javanaut-de/camino/inventor/ls-halterung/ls_halterung.stl

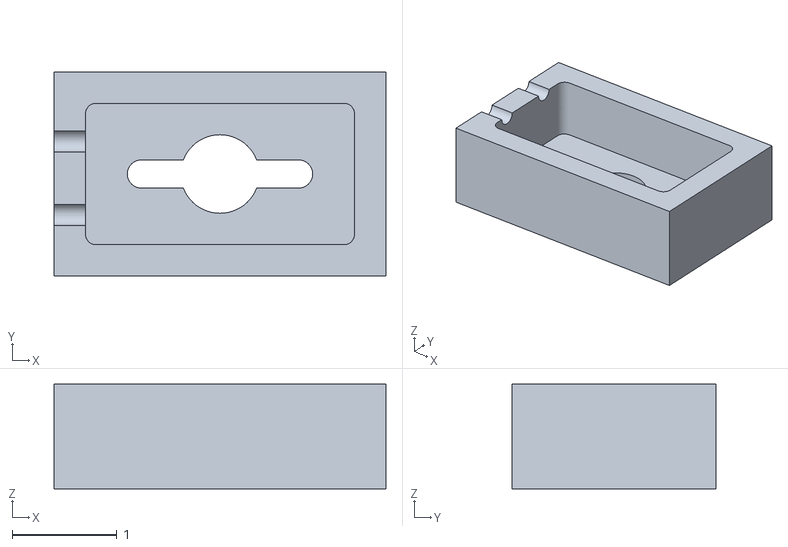
[picture p1: CAD file, 2020-07-20]
inventor/ls-halterung/ls_halterung.stl
3.17 x 1.95 x 1.00
