javanaut-de/camino/inventor/lcd-halterung/oled_halterung_W162_links.stl

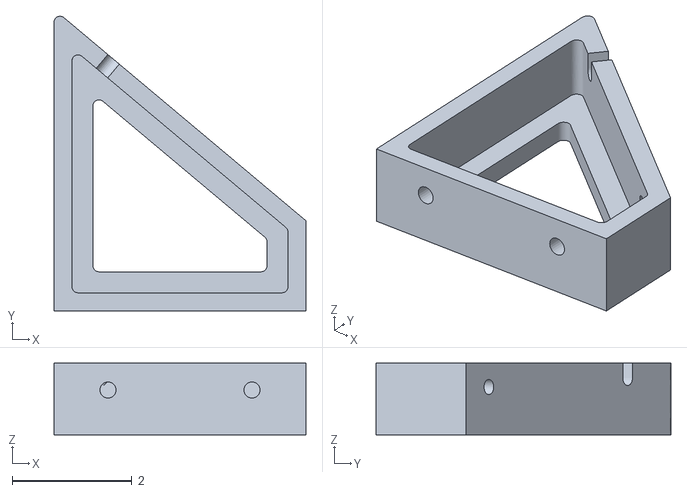
[picture p2: CAD file, 2020-07-20]
inventor/lcd-halterung/oled_halterung_W162_links.stl
4.20 x 4.91 x 1.20
