javanaut-de/camino/inventor/lcd-halterung/lcd_halterung_162C_rechts.stl

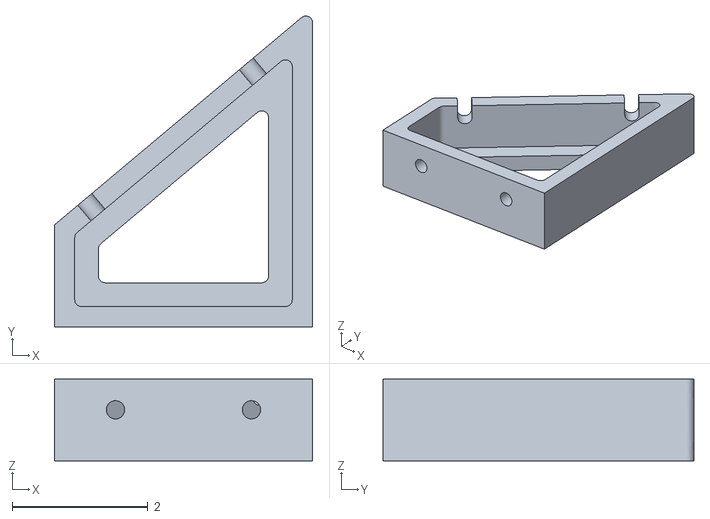
[picture p3: CAD file, 2020-07-20]
inventor/lcd-halterung/lcd_halterung_162C_rechts.stl
3.80 x 4.57 x 1.20
