javanaut-de/camino/(list of files, cad)

Other CAD files:
inventor/lcd-halterung/oled_halterung_W162.dwg
inventor/lcd-halterung/oled_halterung_W162_rechts.stl
inventor/lcd-halterung/lcd_halterung_162C.dwg
inventor/lcd-halterung/lcd_halterung_162C_links.stl
inventor/lcd-halterung/lcd_halterung_162C_links.ipt
inventor/lcd-halterung/lcd_halterung_162C_rechts.ipt
inventor/lcd-halterung/oled_halterung_W162_links.ipt
inventor/lcd-halterung/oled_halterung_W162_rechts.ipt
inventor/ls-halterung/ls-halterung.ipt
