javanaut-de/camino/inventor/lcd-halterung/lcd_halterung_162C.pdf

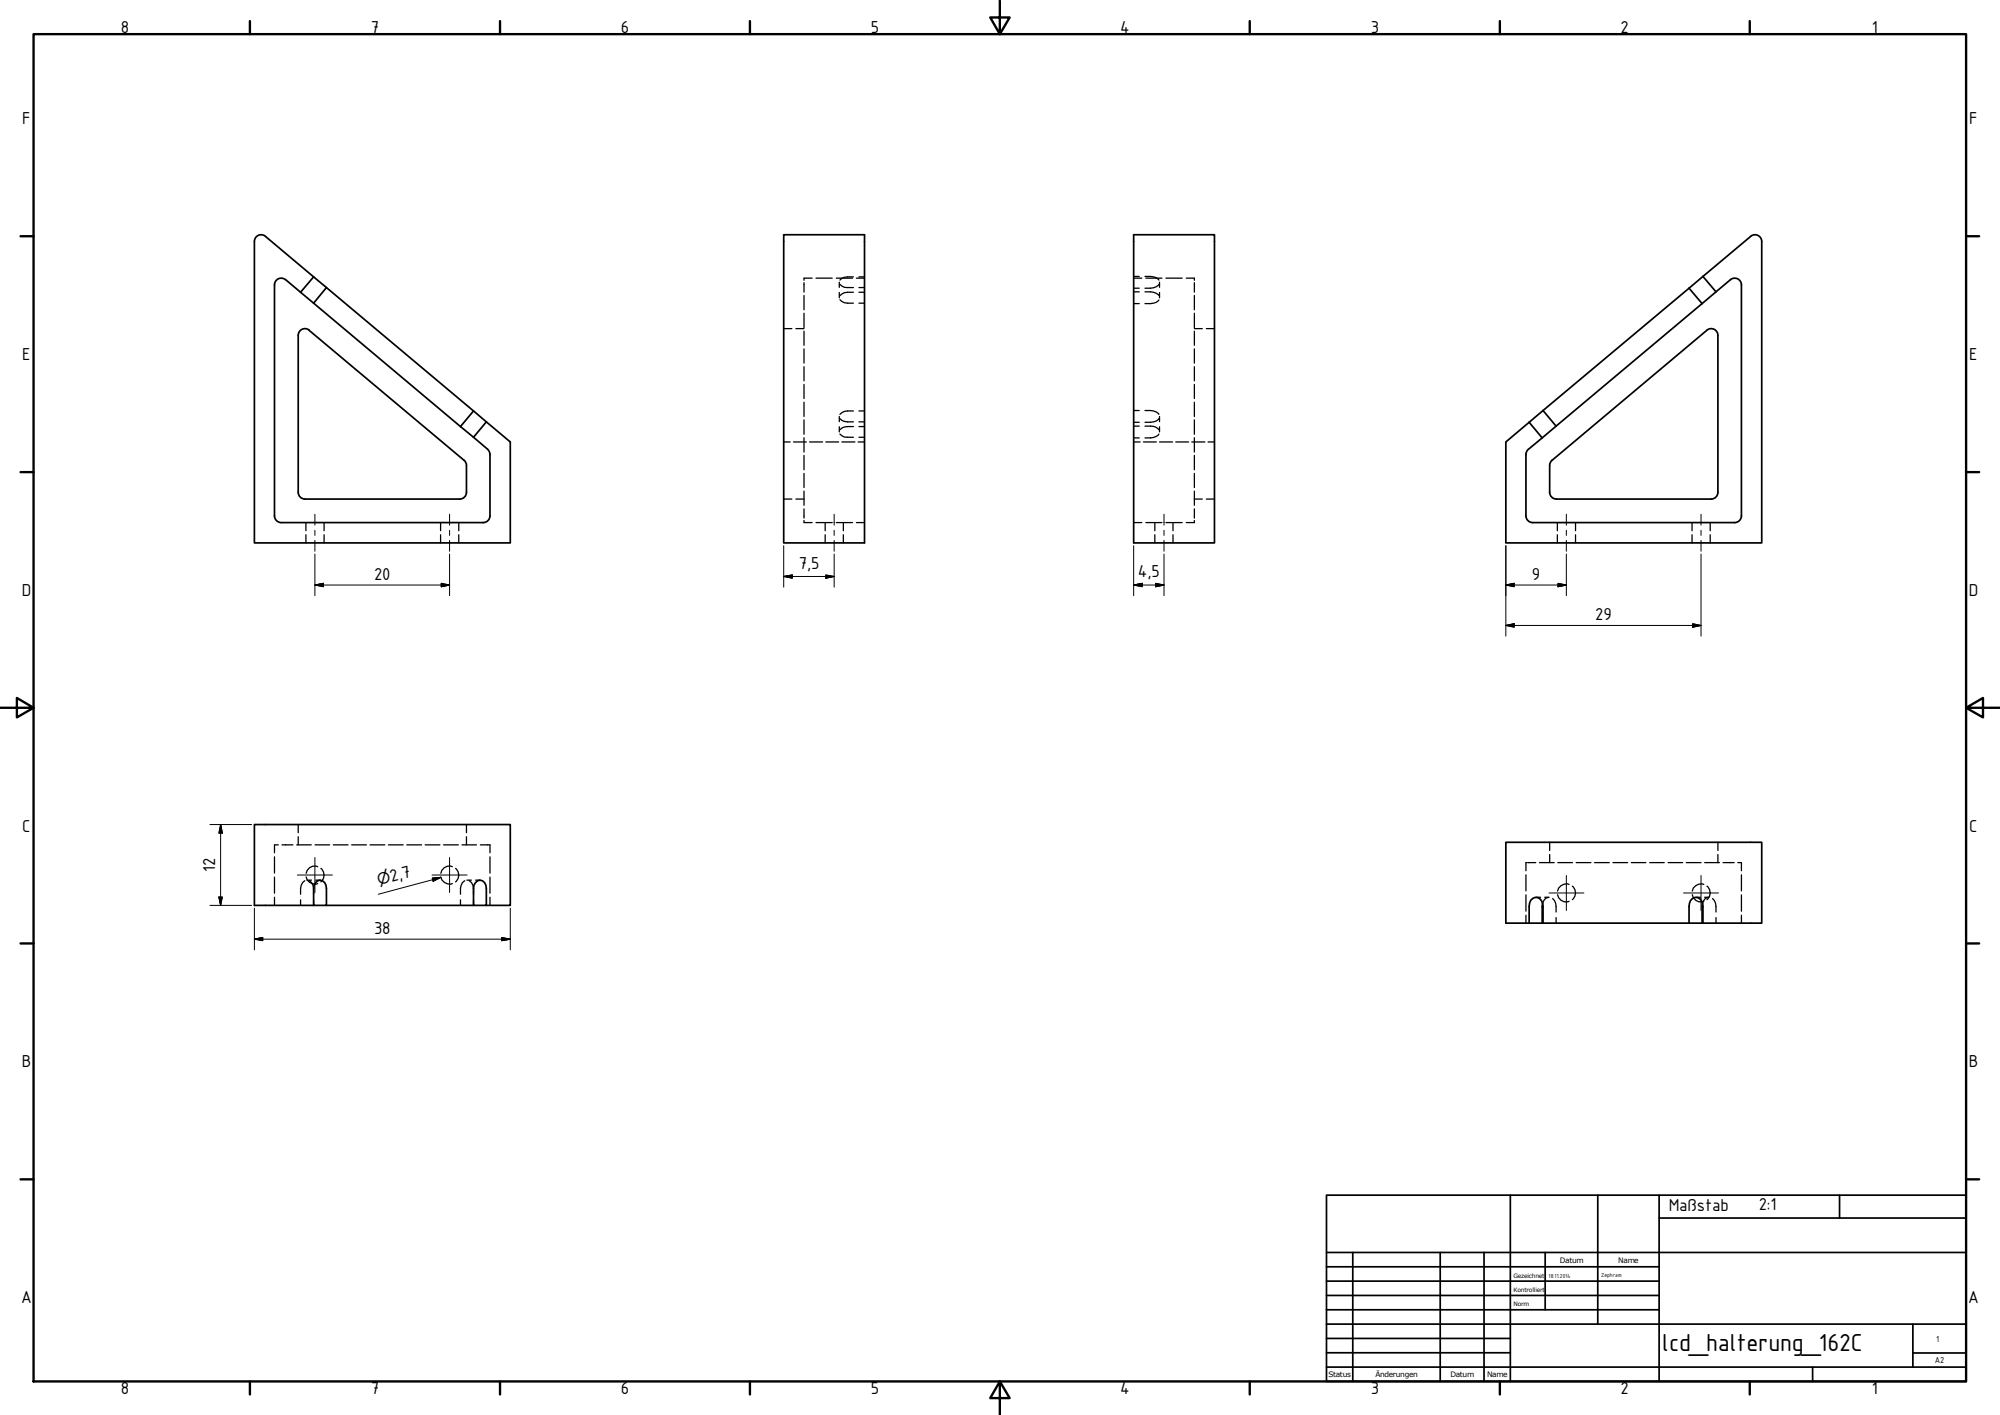
[picture p4: page 1]
lcd_halterung_162C; Status; bnderungen; Datum; Name; Gezeichnet; Kontrolliert; Norm; Zephram; Mastab
