javanaut-de/camino/inventor/lcd-halterung/oled_halterung_W162.pdf

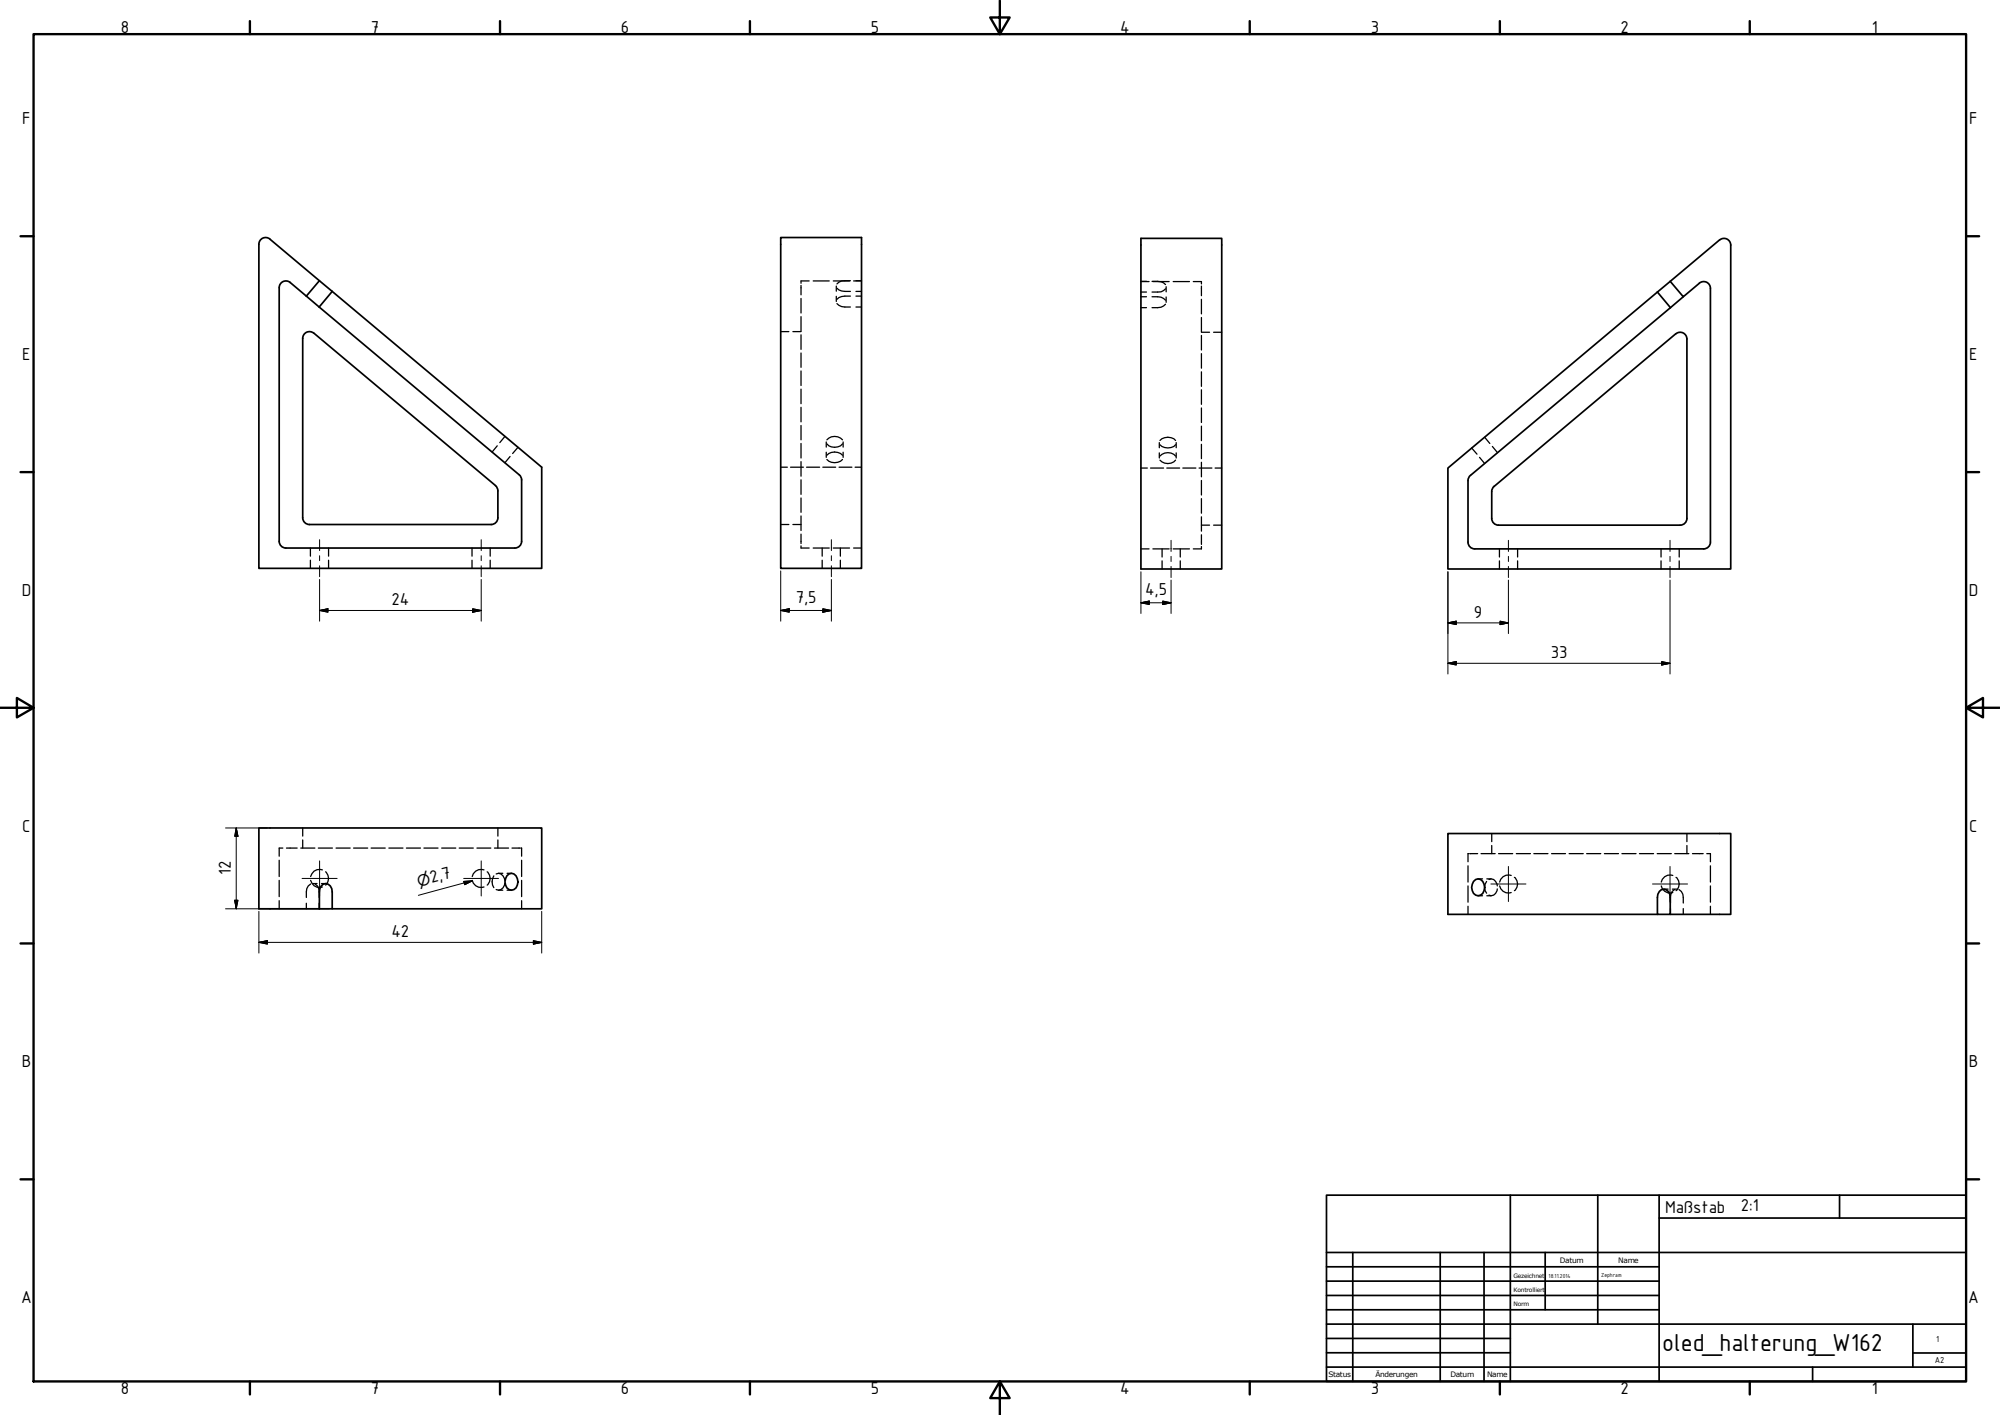
[picture p5: page 1]
oled_halterung_W162; Status; bnderungen; Datum; Name; Gezeichnet; Kontrolliert; Norm; Zephram; Mastab 2:1
