javanaut-de/camino/kicad/camino.kicad_pcb

## KiCad design kicad/camino.kicad_pcb (2020-07-20)

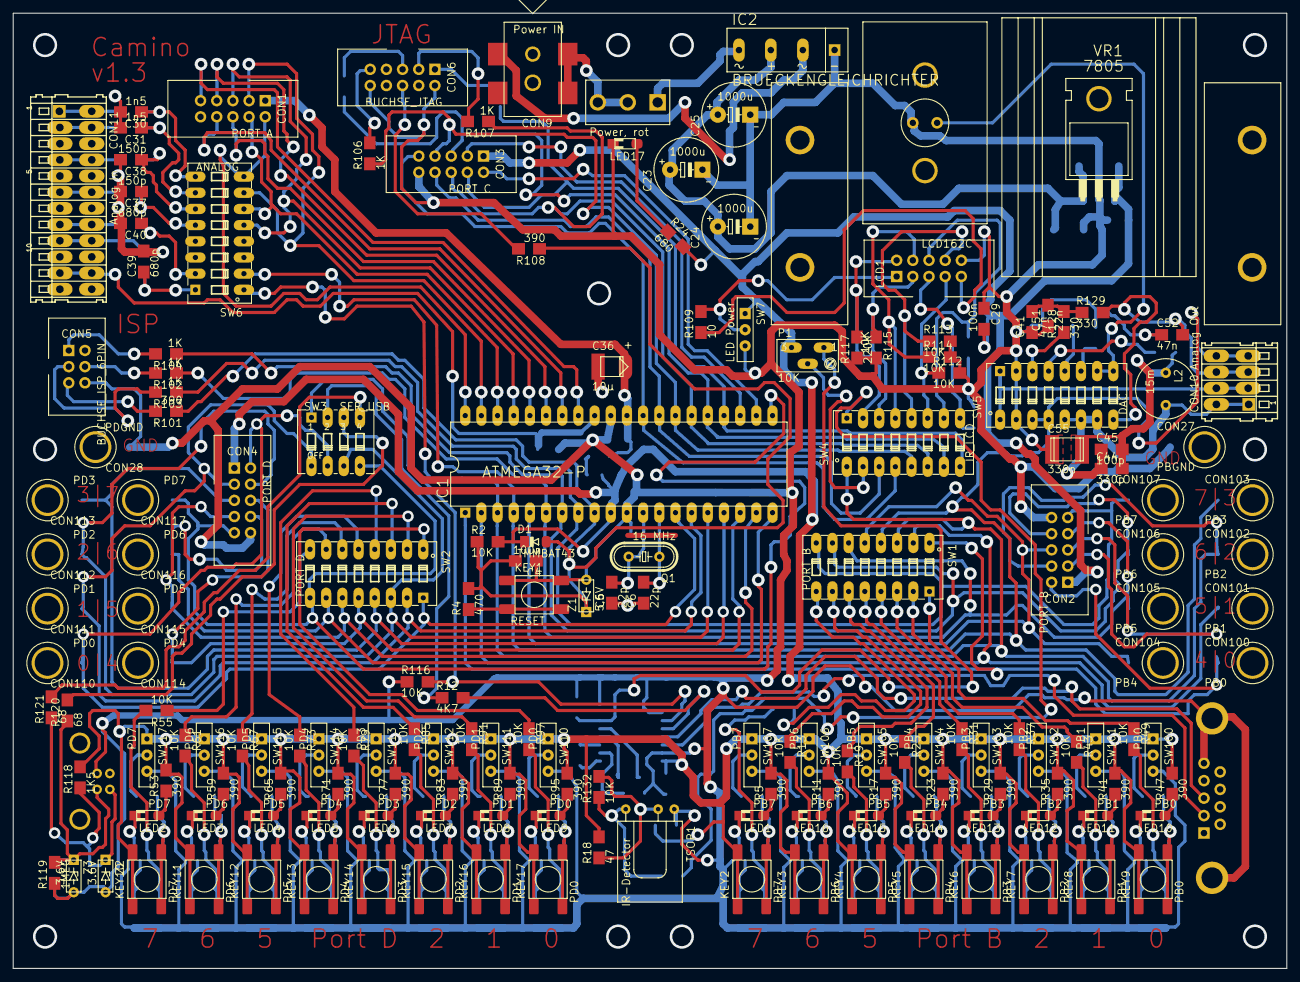
[picture p6: board camino.kicad_pcb from above]

Board: 2 copper layers, 200.0 x 150.0 mm, 306 parts (0 on the bottom side), 216 nets.

Parts:
C1, C2, C3, C4, C26, C28, C29, C32, C33, C34, C35, C47: 100n; KONDENSATOR_SMD_1206
C5, C6: 22p; KONDENSATOR_SMD_1206
C7, C8, C9, C10, C11, C12, C13, C14, C15, C16, C17, C18, C19, C20, C21, C22: 220n; KONDENSATOR_SMD_1206
C23, C24, C25: 1000u; ELKO_RADIAL_11MM
C27, C46, C55: 330n; KONDENSATOR_SMD_1812
C30, C31: 1n5; KONDENSATOR_SMD_1206
C36: 10µ; ELKO_SMD_TM_B
C37, C38: 150p; KONDENSATOR_SMD_1206
C39, C40: 680p; KONDENSATOR_SMD_1206
C41, C52: 47n; KONDENSATOR_SMD_1206
C42, C51: 22n; KONDENSATOR_SMD_1206
C44: 330p; KONDENSATOR_SMD_1206
C45, C49, C50: 100p; KONDENSATOR_SMD_1206
CON1: PORT A; PFOSTENSTIFTLEISTE_10PIN
CON2: PORT B; PFOSTENSTIFTLEISTE_10PIN
CON3: PORT C; PFOSTENSTIFTLEISTE_10PIN
CON4: PORT D; PFOSTENSTIFTLEISTE_10PIN
CON5: BUCHSE_ISP_6PIN; PFOSTENSTIFTLEISTE_6PIN
CON6: BUCHSE_JTAG; PFOSTENSTIFTLEISTE_10PIN
CON7: RS232; BUCHSE_SERIELL_SUBD9_PIN
CON8: BUCHSE_USB_B; BUCHSE_USB_B_PIN
CON9: Power IN; BUCHSE_DC
CON10: Analog Out; KLEMMBUCHSE_WAGO_233_504_4PIN
CON11: Analog In; KLEMMBUCHSE_WAGO_233_512_12PIN
CON27: PBGND; BUCHSE_LABOR_2MM
CON28: PDGND; BUCHSE_LABOR_2MM
CON100: PB0; BUCHSE_LABOR_2MM
CON101: PB1; BUCHSE_LABOR_2MM
CON102: PB2; BUCHSE_LABOR_2MM
CON103: PB3; BUCHSE_LABOR_2MM
CON104: PB4; BUCHSE_LABOR_2MM
CON105: PB5; BUCHSE_LABOR_2MM
CON106: PB6; BUCHSE_LABOR_2MM
CON107: PB7; BUCHSE_LABOR_2MM
CON110: PD0; BUCHSE_LABOR_2MM
CON111: PD1; BUCHSE_LABOR_2MM
CON112: PD2; BUCHSE_LABOR_2MM
CON113: PD3; BUCHSE_LABOR_2MM
CON114: PD4; BUCHSE_LABOR_2MM
CON115: PD5; BUCHSE_LABOR_2MM
CON116: PD6; BUCHSE_LABOR_2MM
CON117: PD7; BUCHSE_LABOR_2MM
D1: TMMBAT43; DIODE_MINIMELF
D2: S4D; DIODE_SMD_DO214AB
IC1: ATMEGA32-P; DIL40
IC2: BRUECKENGLEICHRICHTER; GLEICHRICHTER_SIL4
IC3: MAX202SO16L; SO16L
KEY1: RESET; TASTER_LSG1301
KEY2: PB7; TASTER_LSG1301
KEY3: PB6; TASTER_LSG1301
KEY4: PB5; TASTER_LSG1301
KEY5: PB4; TASTER_LSG1301
KEY6: PB3; TASTER_LSG1301
KEY7: PB2; TASTER_LSG1301
KEY8: PB1; TASTER_LSG1301
KEY9: PB0; TASTER_LSG1301
KEY10: PD7; TASTER_LSG1301
KEY11: PD6; TASTER_LSG1301
KEY12: PD5; TASTER_LSG1301
KEY13: PD4; TASTER_LSG1301
KEY14: PD3; TASTER_LSG1301
KEY15: PD2; TASTER_LSG1301
KEY16: PD1; TASTER_LSG1301
KEY17: PD0; TASTER_LSG1301
L1: 10u; SPULE_SMD_1008
L2: 15m; SPULE_RADIAL_200MIL
LCD1: LCD162C; LCD_PULT_162C_BC
LED1: PB7; LED_KINGBRIGHT
LED2: PD7; LED_KINGBRIGHT
LED3: PD6; LED_KINGBRIGHT
LED4: PD5; LED_KINGBRIGHT
LED5: PD4; LED_KINGBRIGHT
LED6: PD3; LED_KINGBRIGHT
LED7: PD2; LED_KINGBRIGHT
LED8: PD1; LED_KINGBRIGHT
LED9: PD0; LED_KINGBRIGHT
LED10: PB0; LED_KINGBRIGHT
LED11: PB1; LED_KINGBRIGHT
LED12: PB2; LED_KINGBRIGHT
LED13: PB3; LED_KINGBRIGHT
LED14: PB4; LED_KINGBRIGHT
LED15: PB5; LED_KINGBRIGHT
LED16: PB6; LED_KINGBRIGHT
LED17: Power, rot; LED_KINGBRIGHT
P1: 10K; 3296Y
Q1: 16 MHz; HC49U
R1: 4R7; WIDERSTAND_SMD_1206
R2, R7, R10, R13, R16, R19, R22, R25, R28, R31, R34, R37, R40, R43, R46, R49, R52, R55, R58, R61, R64, R67, R70, R73, R76, R79, R82, R85, R88, R91, R94, R97, R100, R110, R111, R112, R113, R114, R115, R116, R122, R123, R124, R125, R132: 10K; WIDERSTAND_SMD_1206
R3, R6, R102, R103, R104, R105, R106, R107: 1K; WIDERSTAND_SMD_1206
R4: 470; WIDERSTAND_SMD_1206
R5, R11, R17, R23, R29, R35, R41, R47, R53, R59, R65, R71, R77, R83, R89, R95, R101, R108: 390; WIDERSTAND_SMD_1206
R8, R14, R20, R26, R30, R32, R36, R38, R42, R44, R48, R50, R54, R56, R60, R62, R66, R68, R72, R74, R78, R80, R84, R86, R90, R92, R96, R98, R133, R134, R135, R136: 470K; WIDERSTAND_SMD_1206
R9, R15, R21, R27, R33, R39, R45, R51, R57, R63, R69, R75, R81, R87, R93, R99, R126, R127: 100K; WIDERSTAND_SMD_1206
R12: 4K7; WIDERSTAND_SMD_1206
R18: 47; WIDERSTAND_SMD_1206
R24: 680; WIDERSTAND_SMD_1206
R109: 10; WIDERSTAND_SMD_1206
R117: 220K; WIDERSTAND_SMD_1206
R118: 1K5; WIDERSTAND_SMD_1206
R119: 1MEG; WIDERSTAND_SMD_1206
R120, R121: 68; WIDERSTAND_SMD_1206
R128, R129, R130, R131: 330; WIDERSTAND_SMD_1206
SPK1: LAUTSPRECHER; LAUTSPRECHER_BOX
SW1: PORT B; SCHALTER_DIP8
SW2: PORT D; SCHALTER_DIP8
SW3: SER_USB; SCHALTER_DIP4
SW4: IR_LCD; SCHALTER_DIP8
SW5: DAC; SCHALTER_DIP8
SW6: ANALOG; SCHALTER_DIP8
SW7: LED Power; SCHALTER_1UM_ESP
SW23: MAIN; SCHALTER_KNITTER
SW100: PB0; SCHALTER_1UM_ESP
SW101: PB1; SCHALTER_1UM_ESP
SW102: PB2; SCHALTER_1UM_ESP
SW103: PB3; SCHALTER_1UM_ESP
SW104: PB4; SCHALTER_1UM_ESP
SW105: PB5; SCHALTER_1UM_ESP
SW106: PB6; SCHALTER_1UM_ESP
SW107: PB7; SCHALTER_1UM_ESP
SW110: PD0; SCHALTER_1UM_ESP
SW111: PD1; SCHALTER_1UM_ESP
SW112: PD2; SCHALTER_1UM_ESP
SW113: PD3; SCHALTER_1UM_ESP
SW114: PD4; SCHALTER_1UM_ESP
SW115: PD5; SCHALTER_1UM_ESP
SW116: PD6; SCHALTER_1UM_ESP
SW117: PD7; SCHALTER_1UM_ESP
T1, T2, T3, T4, T5, T6, T7, T8, T9, T10, T11, T12, T13, T14, T15, T16: IRLML2502; SOT-23
TSOP1: IR-Detector; RECEIVER_TSOP_LIEGEND
VR1: 7805; TO220_LIEGEND_KUEHLKOERPER_STRANG
Z1: 5,6V; ZENER_PIN_200MIL
Z2, Z3: 3.6V; ZENER_PIN_200MIL

Connections:
/RESET: C4.2, D1.A, IC1.9, R2.1, R4.2, R101.1, R108.1, Z1.K
AVCC: C3.2, C36.POS, CON1.P$1, IC1.30, R1.1
GND: C1.1, C2.2, C3.1, C4.1, C5.1, C6.1, C7.1, C8.1, C9.1, C10.1, C11.1, C12.1, C13.1, C14.1, C15.1, C16.1, C17.1, C18.1, C19.1, C20.1, C21.1, C22.1, C23.-, C24.-, C25.-, C26.1, C27.1, C28.1, C29.1, C30.2, C31.2, C34.2, C35.2, C36.NEG, C37.2, C38.2, C39.2, C40.2, C41.1, C42.1, C46.1, C47.1, C49.1, C50.1, C51.1, C52.1, C55.2, CON1.P$10, CON2.P$10, CON3.P$10, CON4.P$10, CON5.P$6, CON6.P$2, CON6.P$10, CON7.5, CON7.G1, CON7.G2, CON8.GND, CON10.A2, CON10.B2, CON11.A3, CON11.A5, CON11.A7, CON11.A10, CON11.A12, CON11.B3, CON11.B5, CON11.B7, CON11.B10, CON11.B12, CON27.PAD, CON28.PAD, IC1.11, IC1.31, IC2.NEG, IC3.8, IC3.10, KEY1.P$1, KEY1.P$2, LCD1.GND, LED17.K, R8.1, R14.1, R20.1, R26.1, R32.1, R38.1, R44.1, R50.1, R56.1, R62.1, R68.1, R74.1, R80.1, R86.1, R92.1, R98.1, R110.2, R111.2, R112.2, R113.2, R114.2, R115.2, R116.1, R117.1, R119.1, R131.1, SPK1.1, SW5.1, SW5.2, SW5.15, SW5.16, SW6.3, SW6.4, SW6.13, SW6.14, SW7.OFF, SW100.OFF, SW101.OFF, SW102.OFF, SW103.OFF, SW104.OFF, SW105.OFF, SW106.OFF, SW107.OFF, SW110.OFF, SW111.OFF, SW112.OFF, SW113.OFF, SW114.OFF, SW115.OFF, SW116.OFF, SW117.OFF, T1.P$2, T2.P$2, T3.P$2, T4.P$2, T5.P$2, T6.P$2, T7.P$2, T8.P$2, T9.P$2, T10.P$2, T11.P$2, T12.P$2, T13.P$2, T14.P$2, T15.P$2, T16.P$2, TSOP1.GND, VR1.2, Z1.A, Z2.A, Z3.A
unnamed: C1.2, CON11.A11, CON11.B11, IC1.32
unnamed: C5.2, IC1.12, Q1.2
unnamed: C6.2, IC1.13, Q1.1
unnamed: C7.2, R7.2, R9.2, R36.2
unnamed: C8.2, R13.2, R15.2, R42.2
unnamed: C9.2, R19.2, R21.2, R48.2
unnamed: C10.2, R25.2, R27.2, R54.2
unnamed: C11.2, R31.2, R33.2, R60.2
unnamed: C12.2, R37.2, R39.2, R66.2
unnamed: C13.2, R43.2, R45.2, R72.2
unnamed: C14.2, R49.2, R51.2, R78.2
unnamed: C15.2, R55.2, R57.2, R136.2
unnamed: C16.2, R61.2, R63.2, R135.2
unnamed: C17.2, R67.2, R69.2, R134.2
unnamed: C18.2, R73.2, R75.2, R133.2
unnamed: C19.2, R30.1, R79.2, R81.2
unnamed: C20.2, R85.2, R87.2, R96.2
unnamed: C21.2, R90.2, R91.2, R93.2
unnamed: C22.2, R84.2, R97.2, R99.2
unnamed: C23.+, C24.+, C25.+, C27.2, D2.K, IC2.POS, VR1.1
unnamed: C30.1, R127.1, SW6.9
unnamed: C31.1, R126.1, SW6.10
unnamed: C32.1, IC3.1
unnamed: C32.2, IC3.3
unnamed: C33.1, IC3.4
unnamed: C33.2, IC3.5
unnamed: C34.1, IC3.2
unnamed: C35.1, IC3.6, P1.A
unnamed: C37.1, R124.1, SW6.12
unnamed: C38.1, R125.1, SW6.11
unnamed: C39.1, R122.1, SW6.16
unnamed: C40.1, R123.1, SW6.15
unnamed: C41.2, C51.2, R128.2, R129.1
unnamed: C42.2, C52.2, CON10.A3, CON10.B3, R129.2, SW5.8
unnamed: C44.1, C45.1, CON10.A1, CON10.B1, L2.P$2, SW5.5, SW5.6, SW5.7
unnamed: C44.2, C45.2, C55.1, L2.P$1, R130.2
unnamed: C46.2, SW5.12
unnamed: C49.2, CON8.D-, R118.1, R121.1, Z2.K
unnamed: C50.2, CON8.D+, R119.2, R120.1, Z3.K
unnamed: CON1.P$2, IC1.40, SW6.8
unnamed: CON1.P$3, IC1.39, SW6.7
unnamed: CON1.P$4, IC1.38, SW6.6
unnamed: CON1.P$5, IC1.37, SW6.5
unnamed: CON1.P$6, IC1.36
unnamed: CON1.P$7, IC1.35
unnamed: CON1.P$8, IC1.34
unnamed: CON1.P$9, IC1.33
unnamed: CON3.P$2, IC1.22
unnamed: CON3.P$3, IC1.23
unnamed: CON3.P$4, IC1.24, R105.1, SW4.8
unnamed: CON3.P$5, IC1.25, R3.1, SW4.7
unnamed: CON3.P$6, IC1.26, R107.1, SW4.6
unnamed: CON3.P$7, IC1.27, R106.1, SW4.5
unnamed: CON3.P$8, IC1.28, SW4.3
unnamed: CON3.P$9, IC1.29, SW4.4
unnamed: CON5.P$1, R104.2
unnamed: CON5.P$3, R103.2
unnamed: CON5.P$4, R102.2
unnamed: CON5.P$5, R101.2
unnamed: CON6.P$1, R105.2
unnamed: CON6.P$3, R107.2
unnamed: CON6.P$5, R3.2
unnamed: CON6.P$6, R108.2
unnamed: CON6.P$9, R106.2
unnamed: CON7.2, IC3.14
unnamed: CON7.3, IC3.13
unnamed: CON9.FEDER, IC2.AC2
unnamed: CON9.STIFT_A, CON9.STIFT_B, SW23.OFF, SW23.SW
unnamed: CON2.P$5, CON10.A4, CON10.B4, CON103.PAD, IC1.4, SW1.4, SW5.3, SW5.4, SW6.2
unnamed: CON11.A1, CON11.B1, R127.2
unnamed: CON11.A2, CON11.B2, R126.2
unnamed: CON11.A4, CON11.B4, R125.2
unnamed: CON11.A6, CON11.B6, R124.2
unnamed: CON11.A8, CON11.B8, R123.2
unnamed: CON11.A9, CON11.B9, R122.2
unnamed: CON2.P$2, CON100.PAD, IC1.1, SW1.1
unnamed: CON2.P$3, CON101.PAD, IC1.2, SW1.2
unnamed: CON2.P$4, CON102.PAD, IC1.3, SW1.3, SW4.1, SW6.1
unnamed: CON2.P$6, CON104.PAD, IC1.5, SW1.5
unnamed: CON2.P$7, CON105.PAD, IC1.6, R102.1, SW1.6
unnamed: CON2.P$8, CON106.PAD, IC1.7, R104.1, SW1.7
unnamed: CON2.P$9, CON107.PAD, IC1.8, R103.1, SW1.8
unnamed: CON4.P$2, CON110.PAD, IC1.14, SW2.16, SW3.2
unnamed: CON4.P$3, CON111.PAD, IC1.15, SW2.15, SW3.1
unnamed: CON4.P$4, CON112.PAD, IC1.16, SW2.14, SW3.3
unnamed: CON4.P$5, CON113.PAD, IC1.17, SW2.13
unnamed: CON4.P$6, CON114.PAD, IC1.18, SW2.12
unnamed: CON4.P$7, CON115.PAD, IC1.19, SW2.11
unnamed: CON4.P$8, CON116.PAD, IC1.20, SW2.10
unnamed: CON4.P$9, CON117.PAD, IC1.21, SW2.9, SW3.4
unnamed: IC2.AC1, SW23.ON
unnamed: IC3.11, R116.2, SW3.8
unnamed: IC3.12, R12.2
unnamed: KEY1.P$3, KEY1.P$4, R4.1
unnamed: KEY2.P$3, KEY2.P$4, R9.1, R10.2
unnamed: KEY3.P$3, KEY3.P$4, R15.1, R16.2
unnamed: KEY4.P$3, KEY4.P$4, R21.1, R22.2
unnamed: KEY5.P$3, KEY5.P$4, R27.1, R28.2
unnamed: KEY6.P$3, KEY6.P$4, R33.1, R34.2
unnamed: KEY7.P$3, KEY7.P$4, R39.1, R40.2
unnamed: KEY8.P$3, KEY8.P$4, R45.1, R46.2
unnamed: KEY9.P$3, KEY9.P$4, R51.1, R52.2
unnamed: KEY10.P$3, KEY10.P$4, R57.1, R58.2
unnamed: KEY11.P$3, KEY11.P$4, R63.1, R64.2
unnamed: KEY12.P$3, KEY12.P$4, R69.1, R70.2
unnamed: KEY13.P$3, KEY13.P$4, R75.1, R76.2
unnamed: KEY14.P$3, KEY14.P$4, R81.1, R82.2
unnamed: KEY15.P$3, KEY15.P$4, R87.1, R88.2
unnamed: KEY16.P$3, KEY16.P$4, R93.1, R94.2
unnamed: KEY17.P$3, KEY17.P$4, R99.1, R100.2
unnamed: L1.P$1, R1.2
unnamed: LCD1.DB0, R110.1, SW4.9
unnamed: LCD1.DB1, R111.1, SW4.10
unnamed: LCD1.DB2, R112.1, SW4.11
unnamed: LCD1.DB3, R113.1, SW4.12
unnamed: LCD1.E, R114.1, SW4.13
unnamed: LCD1.RS, R115.1, SW4.14
unnamed: LCD1.VCC, R109.2, SW7.SLIDER
unnamed: LCD1.VCON, R117.2, SW4.15
unnamed: LCD1.VLED, R109.1
unnamed: LED1.A, R5.1
unnamed: LED1.K, T1.P$3
unnamed: LED2.A, R53.1
unnamed: LED2.K, T9.P$3
unnamed: LED3.A, R59.1
unnamed: LED3.K, T10.P$3
unnamed: LED4.A, R65.1
unnamed: LED4.K, T11.P$3
unnamed: LED5.A, R71.1
unnamed: LED5.K, T12.P$3
unnamed: LED6.A, R77.1
unnamed: LED6.K, T13.P$3
unnamed: LED7.A, R83.1
unnamed: LED7.K, T14.P$3
unnamed: LED8.A, R89.1
unnamed: LED8.K, T15.P$3
unnamed: LED9.A, R95.1
unnamed: LED9.K, T16.P$3
unnamed: LED10.A, R47.1
unnamed: LED10.K, T8.P$3
unnamed: LED11.A, R41.1
unnamed: LED11.K, T7.P$3
unnamed: LED12.A, R35.1
unnamed: LED12.K, T6.P$3
unnamed: LED13.A, R29.1
unnamed: LED13.K, T5.P$3
unnamed: LED14.A, R23.1
unnamed: LED14.K, T4.P$3
unnamed: LED15.A, R17.1
unnamed: LED15.K, T3.P$3
unnamed: LED16.A, R11.1
unnamed: LED16.K, T2.P$3
unnamed: LED17.A, R24.1
unnamed: P1.S, SW4.2
unnamed: R6.2, SW4.16
unnamed: R7.1, SW1.9
unnamed: R10.1, SW107.SLIDER
unnamed: R12.1, SW3.7
unnamed: R13.1, SW1.10
unnamed: R14.2, R42.1, T2.P$1
unnamed: R16.1, SW106.SLIDER
unnamed: R19.1, SW1.11
unnamed: R20.2, R48.1, T3.P$1
unnamed: R22.1, SW105.SLIDER
unnamed: R25.1, SW1.12
unnamed: R26.2, R54.1, T4.P$1
unnamed: R28.1, SW104.SLIDER
unnamed: R30.2, R80.2, T13.P$1
unnamed: R31.1, SW1.13
unnamed: R32.2, R60.1, T5.P$1
unnamed: R34.1, SW103.SLIDER
unnamed: R8.2, R36.1, T1.P$1
unnamed: R37.1, SW1.14
unnamed: R38.2, R66.1, T6.P$1
unnamed: R40.1, SW102.SLIDER
unnamed: R43.1, SW1.15
unnamed: R44.2, R72.1, T7.P$1
unnamed: R46.1, SW101.SLIDER
unnamed: R49.1, SW1.16
unnamed: R50.2, R78.1, T8.P$1
unnamed: R52.1, SW100.SLIDER
unnamed: R55.1, SW2.8
unnamed: R58.1, SW117.SLIDER
unnamed: R61.1, SW2.7
unnamed: R64.1, SW116.SLIDER
unnamed: R67.1, SW2.6
unnamed: R70.1, SW115.SLIDER
unnamed: R73.1, SW2.5
unnamed: R76.1, SW114.SLIDER
unnamed: R79.1, SW2.4
unnamed: R82.1, SW113.SLIDER
unnamed: R84.1, R98.2, T16.P$1
unnamed: R85.1, SW2.3
unnamed: R86.2, R96.1, T14.P$1
unnamed: R88.1, SW112.SLIDER
unnamed: R90.1, R92.2, T15.P$1
unnamed: R91.1, SW2.2
unnamed: R94.1, SW111.SLIDER
unnamed: R97.1, SW2.1
unnamed: R100.1, SW110.SLIDER
unnamed: R120.2, SW3.6
unnamed: R121.2, SW3.5
unnamed: R128.1, SW5.14
unnamed: R130.1, SW5.13
unnamed: R131.2, SW5.11
unnamed: R6.1, R132.1, TSOP1.OUT
unnamed: R18.1, R132.2, TSOP1.VS
unnamed: R74.2, R133.1, T12.P$1
unnamed: R68.2, R134.1, T11.P$1
unnamed: R62.2, R135.1, T10.P$1
unnamed: R56.2, R136.1, T9.P$1
unnamed: SPK1.2, SW5.9, SW5.10
VCC: C2.1, C26.2, C28.2, C29.2, C47.2, CON2.P$1, CON3.P$1, CON4.P$1, D1.K, D2.A, IC1.10, KEY2.P$1, KEY2.P$2, KEY3.P$1, KEY3.P$2, KEY4.P$1, KEY4.P$2, KEY5.P$1, KEY5.P$2, KEY6.P$1, KEY6.P$2, KEY7.P$1, KEY7.P$2, KEY8.P$1, KEY8.P$2, KEY9.P$1, KEY9.P$2, KEY10.P$1, KEY10.P$2, KEY11.P$1, KEY11.P$2, KEY12.P$1, KEY12.P$2, KEY13.P$1, KEY13.P$2, KEY14.P$1, KEY14.P$2, KEY15.P$1, KEY15.P$2, KEY16.P$1, KEY16.P$2, KEY17.P$1, KEY17.P$2, L1.P$2, P1.E, R2.2, R5.2, R11.2, R17.2, R18.2, R23.2, R24.2, R29.2, R35.2, R41.2, R47.2, R53.2, R59.2, R65.2, R71.2, R77.2, R83.2, R89.2, R95.2, R118.2, SW7.ON, SW100.ON, SW101.ON, SW102.ON, SW103.ON, SW104.ON, SW105.ON, SW106.ON, SW107.ON, SW110.ON, SW111.ON, SW112.ON, SW113.ON, SW114.ON, SW115.ON, SW116.ON, SW117.ON, VR1.3
